Ekter/fishe/README.md

# fishe

This is the project of the Fishe.

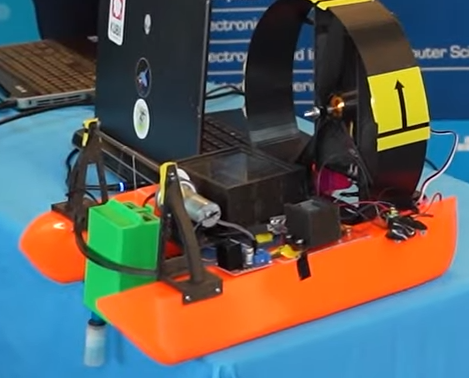
[picture p1: Reports/Reports_Nino_Mulac/images_and_videos_for_reports/fishe_photo_display.png]
Fishe


In fact, this is a high seas recon unit, whose purpose is to collect data on the environment.

Read the reports for further information.
