Ekter/fishe/Conception/README.md

# Conception

This folder will contain the 3D models of the pieces needed to build the robot alongside the 2D models of electronics circuits and laser beam cut pieces.

--------------------------------------------------------------------

Ce dossier contiendra les modèles 3D des pièces nécessaires à la construction du robot ainsi que les modèles 2D des circuits électroniques et des pièces découpées au laser.
