Ekter/fishe/Reports/Rapport_Nathan/Report20_ND.docx

Report 02/05/2023

During this last session before the presentation, I correct and print again pieces that had a problem during the printing. I also designed and print two box to protect the Jetson nano card and the Arduino nano that we use to order our robot.

After doing so I also work on the system of the pulley that and it was hand made.

I finished the session by filing the different piece that I have to make it more useful for the assembly.

We only have to assembly all of our piece together and test the floatability of the boat and also try all the program all together.
