Ekter/fishe/Reports/Rapport_Nathan/Report17_ND.docx

Report 21/03/2023

In this two hours session, I work on the piece that will link both of the pale of the rudder. It took some time to adapt it and make it at the exact length.

Moreover, due to my computer, the time need to work on Fusion360 increased. I need to switch between to project to have the exact length, and after that, I uploaded it on the complete protection project and assemble it to make verification and adapt it.

Finally I print it, to use it next time
