Ekter/fishe/Reports/Fishe diapo oral.pdf

# Fishe

Dumand Nathan
Mulac Nino
Rob3

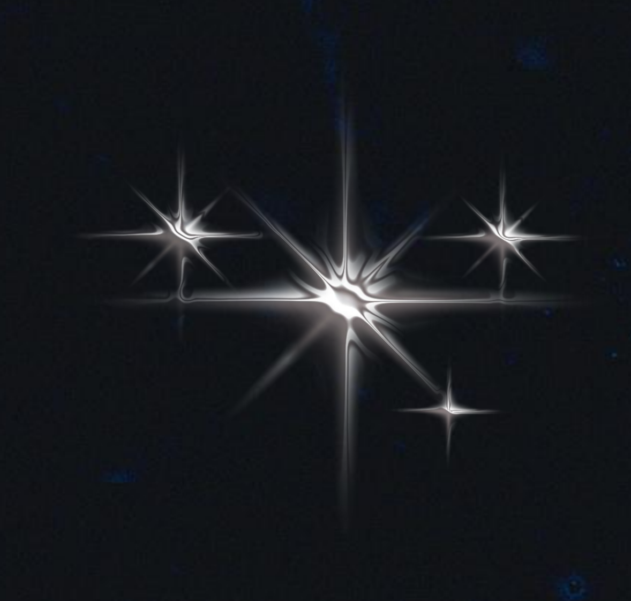
[picture p65: figure]

09/05/2023

Sommaire ● Fonctionnement général ● Le bateau ○ Mécanique ○ Électronique ○ Informatique ● La sonde ○ Mécanique ○ Électronique ○ Informatique

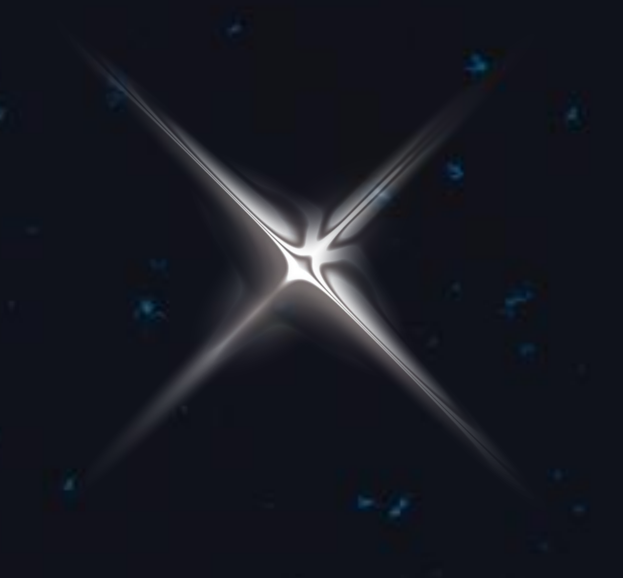
[picture p66: figure]

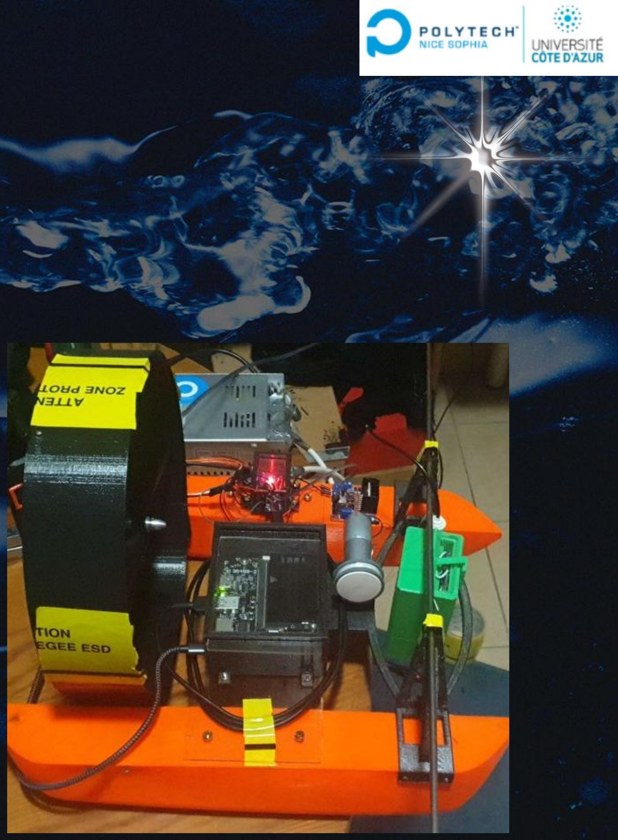
[picture p67: figure]

# Fonctionnement général

- Aéroglisseur
- Sonde
- Sauvegarde des données

# Le bateau

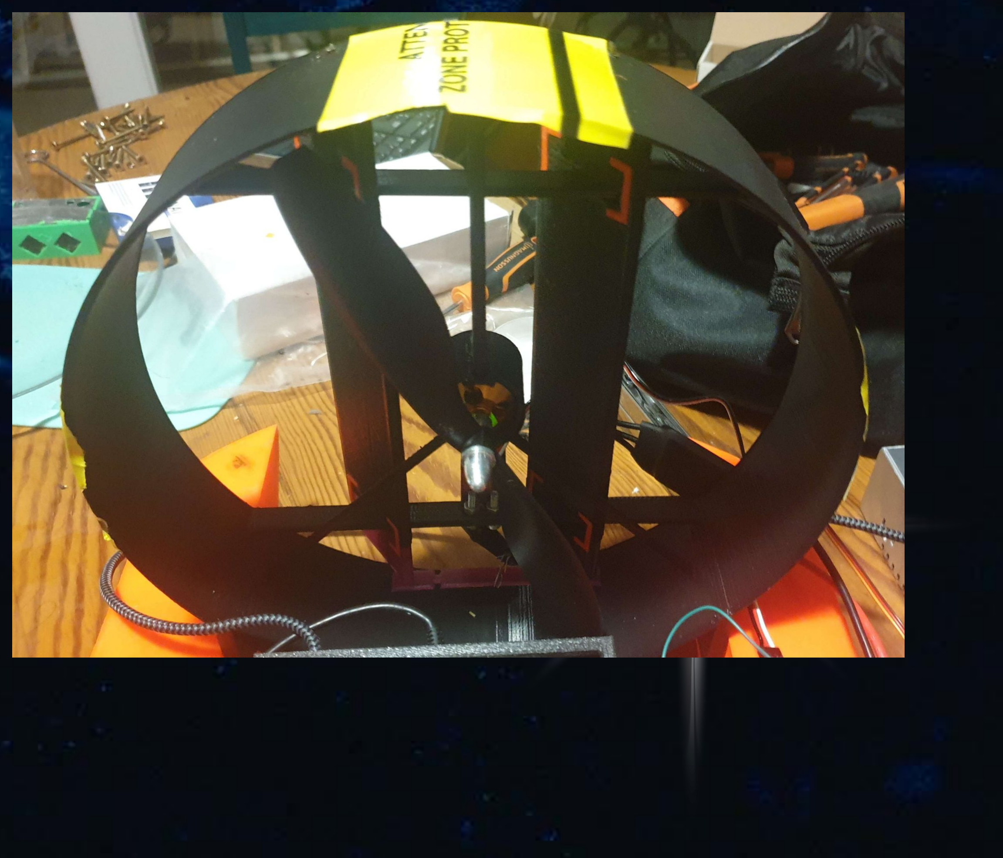
[picture p68: figure]

- Flotteur
- Système de déplacement
- Gouvernail
- Treuil

# Mécanique

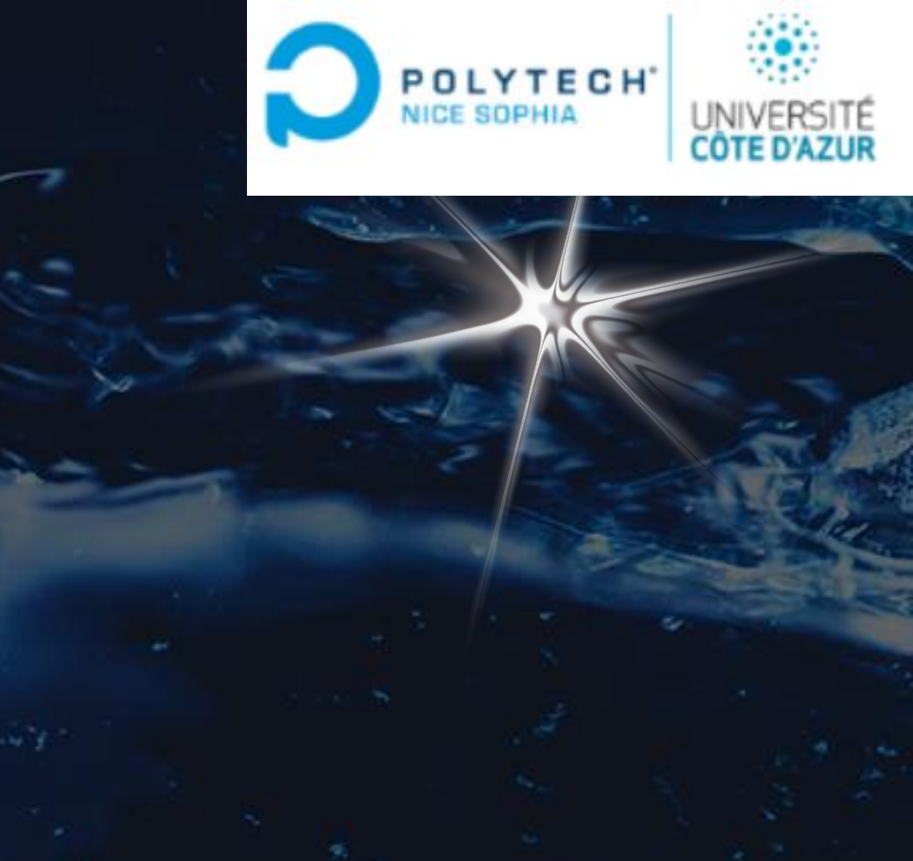
[picture p69: figure]

# Le bateau

# Électronique

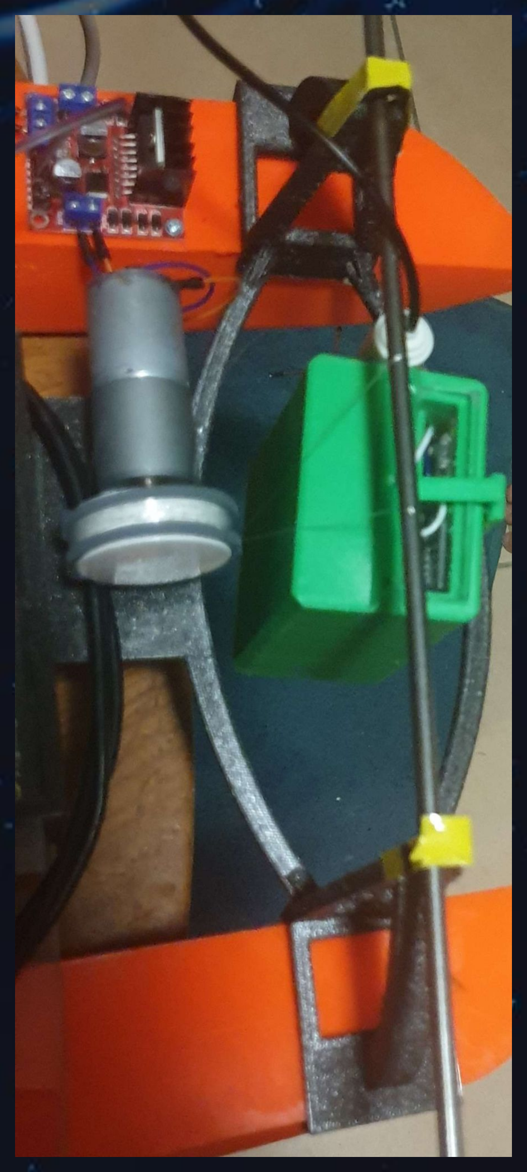
[picture p70: figure]
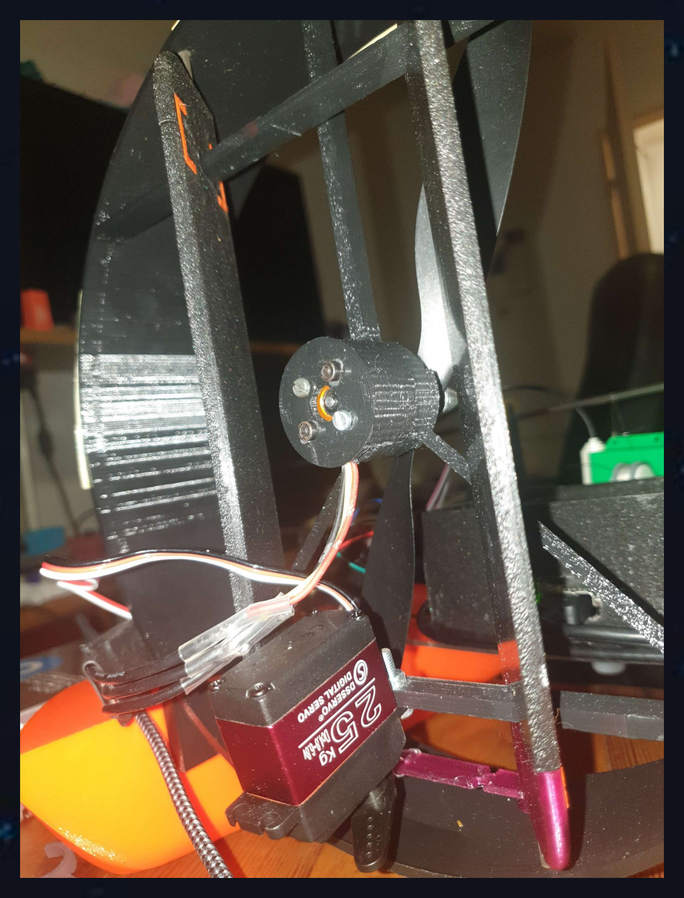
[picture p71: figure]

- Moteur
- Brushless + ESC
- Servo
- Moteur CC + pont en H
- 2 pistes de tension

# Le bateau

# Informatique

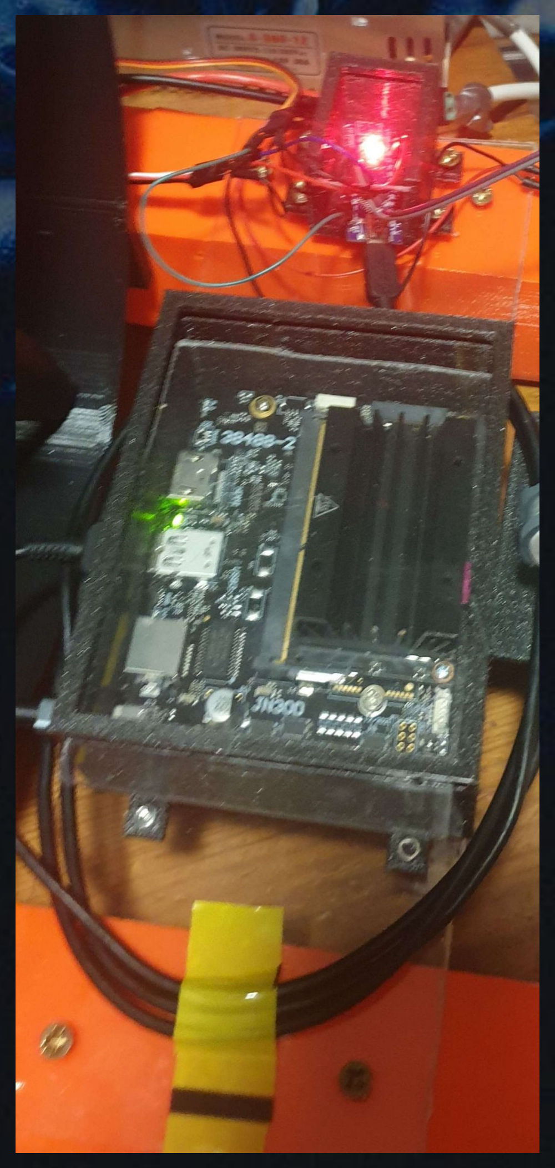
[picture p72: figure]

- Auvidea Jetson Nano
- Base de données
- Pilote du mouvement
- Arduino Nano
- Esclave
- Moteur

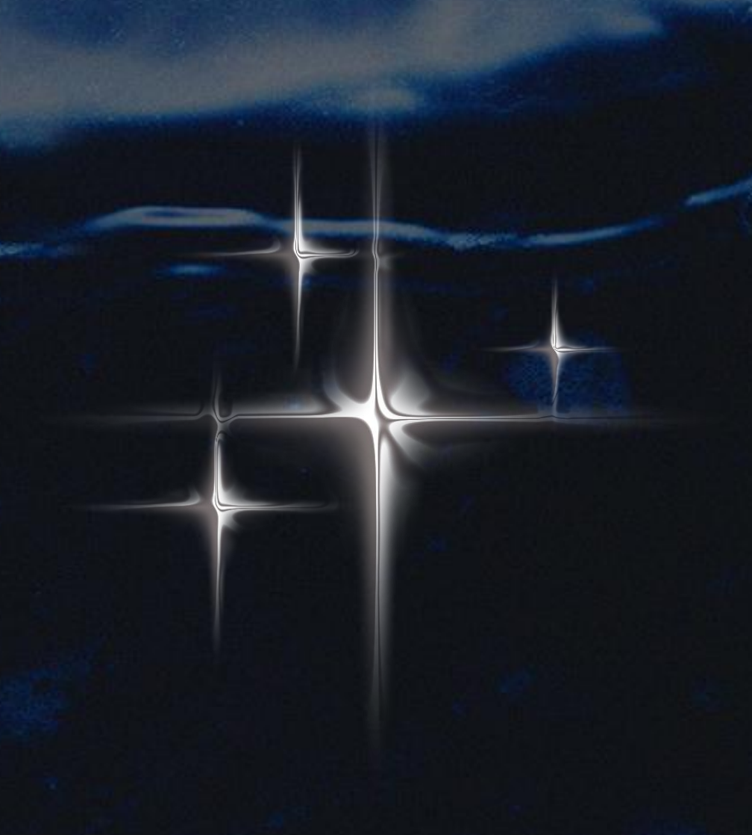
[picture p73: figure]

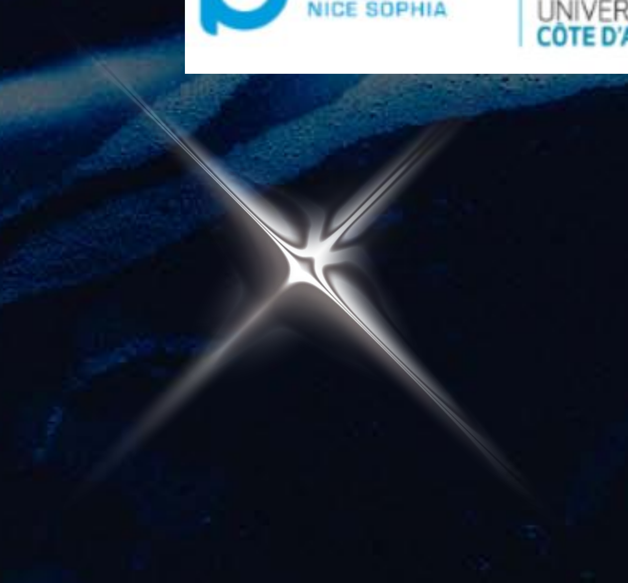
[picture p74: figure]

# La sonde

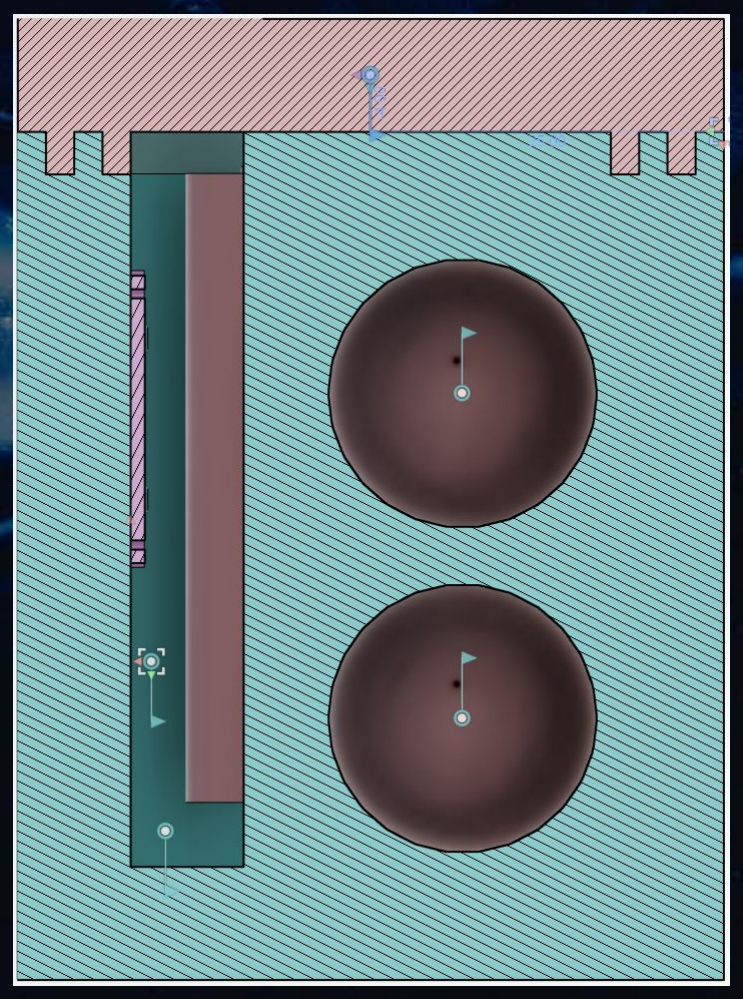
[picture p75: figure]

- Étanchéité
- Résistance aux fortes pressions

# Mécanique

# La sonde

# Électronique

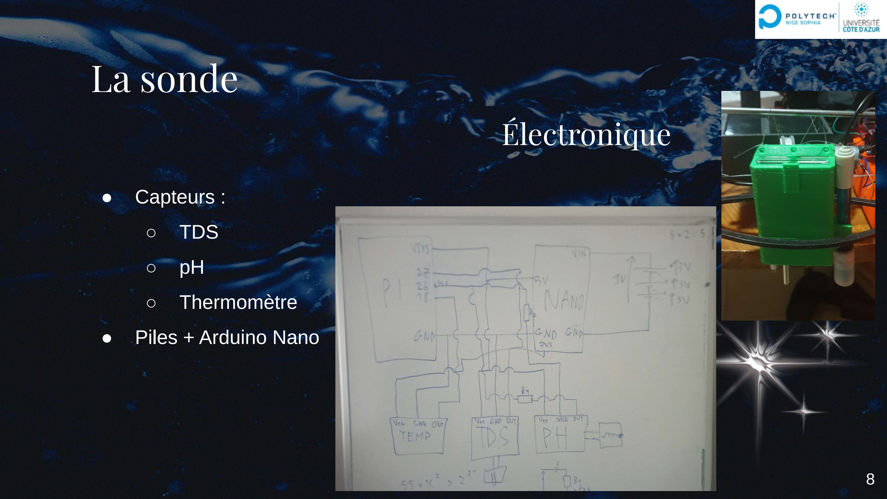
[picture p76: page 8]

- Capteurs :
- TDS
- pH
- Thermomètre
- Piles + Arduino Nano

# La sonde

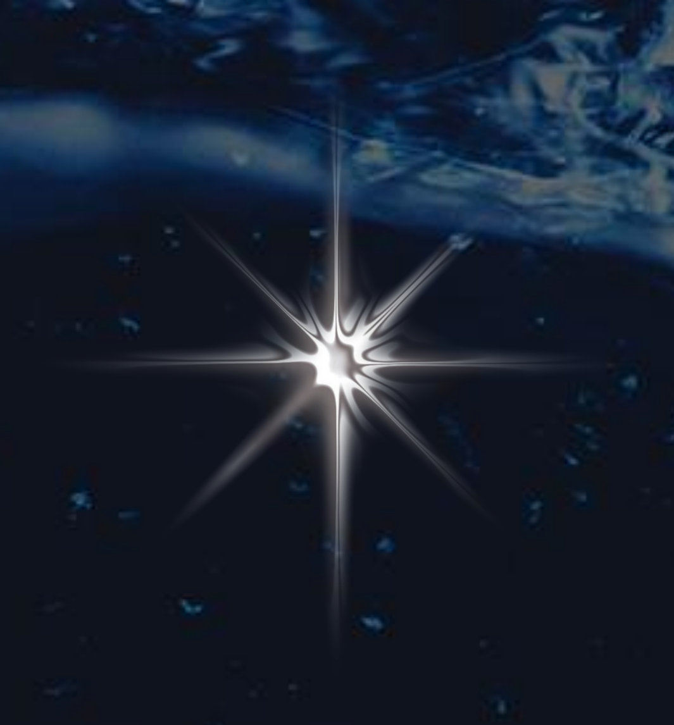
[picture p77: figure]

# Informatique

- Programme résistant au crash
- Lancement automatique
- Transmission d’information

# Démonstration

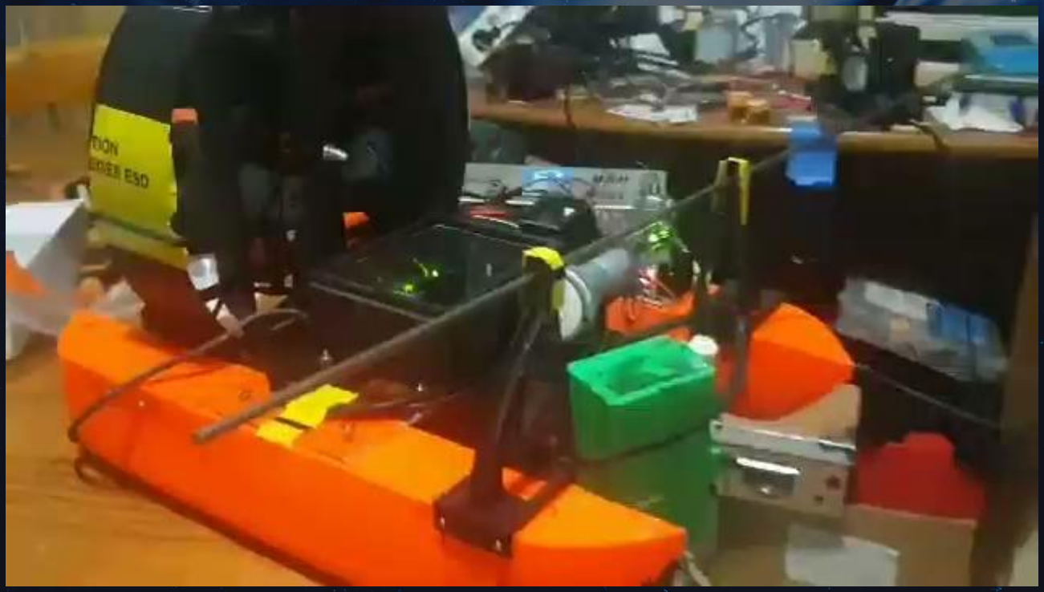
[picture p78: figure]

# Démonstration

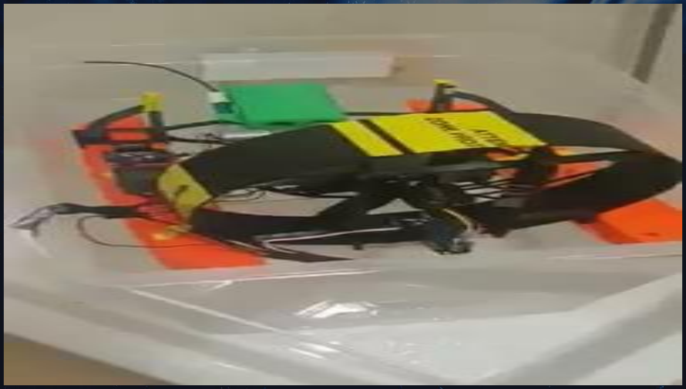
[picture p79: figure]

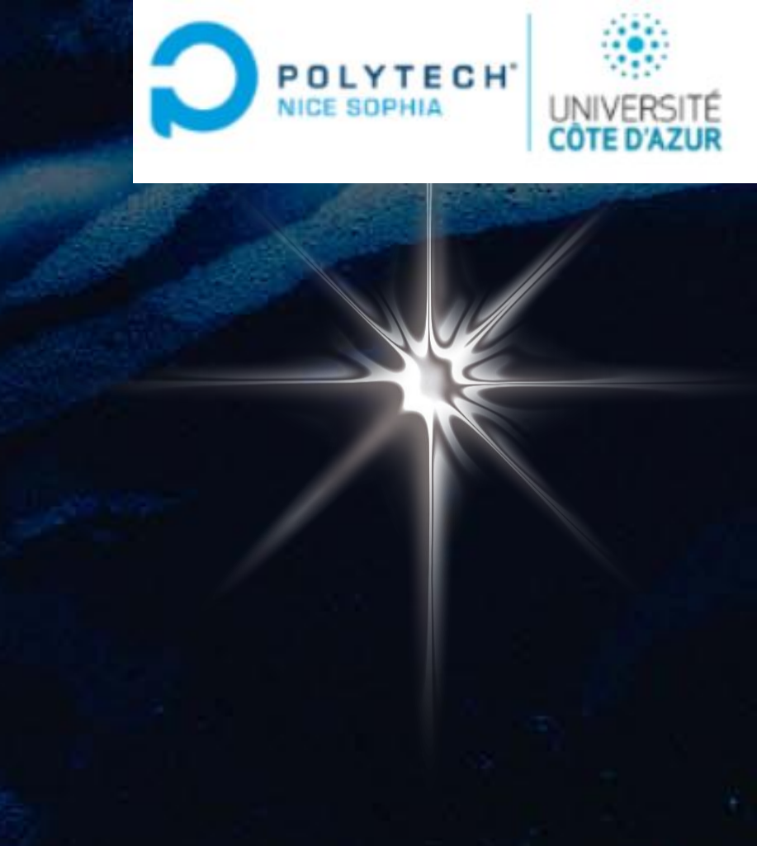
[picture p80: figure]

# Conclusion

- Batterie + panneaux solaires
- Résistance à l’eau
- Position GPS
- Profondeur de la sonde
- Repérage d’obstacle

### Bibliographie

How to reverse motor direction with ESC with reverse function? - Motors, Mechanics, Power and CNC - Arduino Forum
Reversing BLDC motor standard rotation.
Le robot inspiré des méduses se déplace comme le nageur le plus efficace de la nature jellyfish propulsion
How do jellyfish swim? | Earth | EarthSky
forces applied by swimming jellyfish
Drag coefficient - Wikipedia
profiles aerodynamics / hydrodynamics profiles NACA Intergovernmental Panel on Climate Change - Wikipedia AR6 Synthesis Report: Climate Change 2022 — IPCC Carbon dioxide - Wikipedia
Arduino based hovercraft
aircraft propellers and how they work
