Ekter/fishe/Reports/README.md

# Code

This folder will contain all reports. This includes the initial report, the weekly reports, the final report, and the presentation slides.

--------------------------------------------------------------------

Ce dossier contiendra tous les rapports. Cela inclut le rapport initial, les rapports hebdomadaires, le rapport final, et les diapositives de la présentation.
