Ekter/fishe/Models/README.md

# Conception

This folder will contain the physical modelisations for the robot.

--------------------------------------------------------------------

Ce dossier contiendra les modélisations physiques du robot.
