Ekter/fishe/Archives/README.md

# Code

This folder contains old versions of the code, and other things not needed anymore. The current version is in the [Code](../Code) folder.

--------------------------------------------------------------------

Ce dossier contient les anciennes versions du code, et d'autres choses qui ne sont plus nécessaires. La version actuelle est dans le dossier [Code](../Code).
