Ekter/fishe/Reports/Reports_Nino_Mulac/images_and_videos_for_reports/electrical_diagram_boat_nice.png

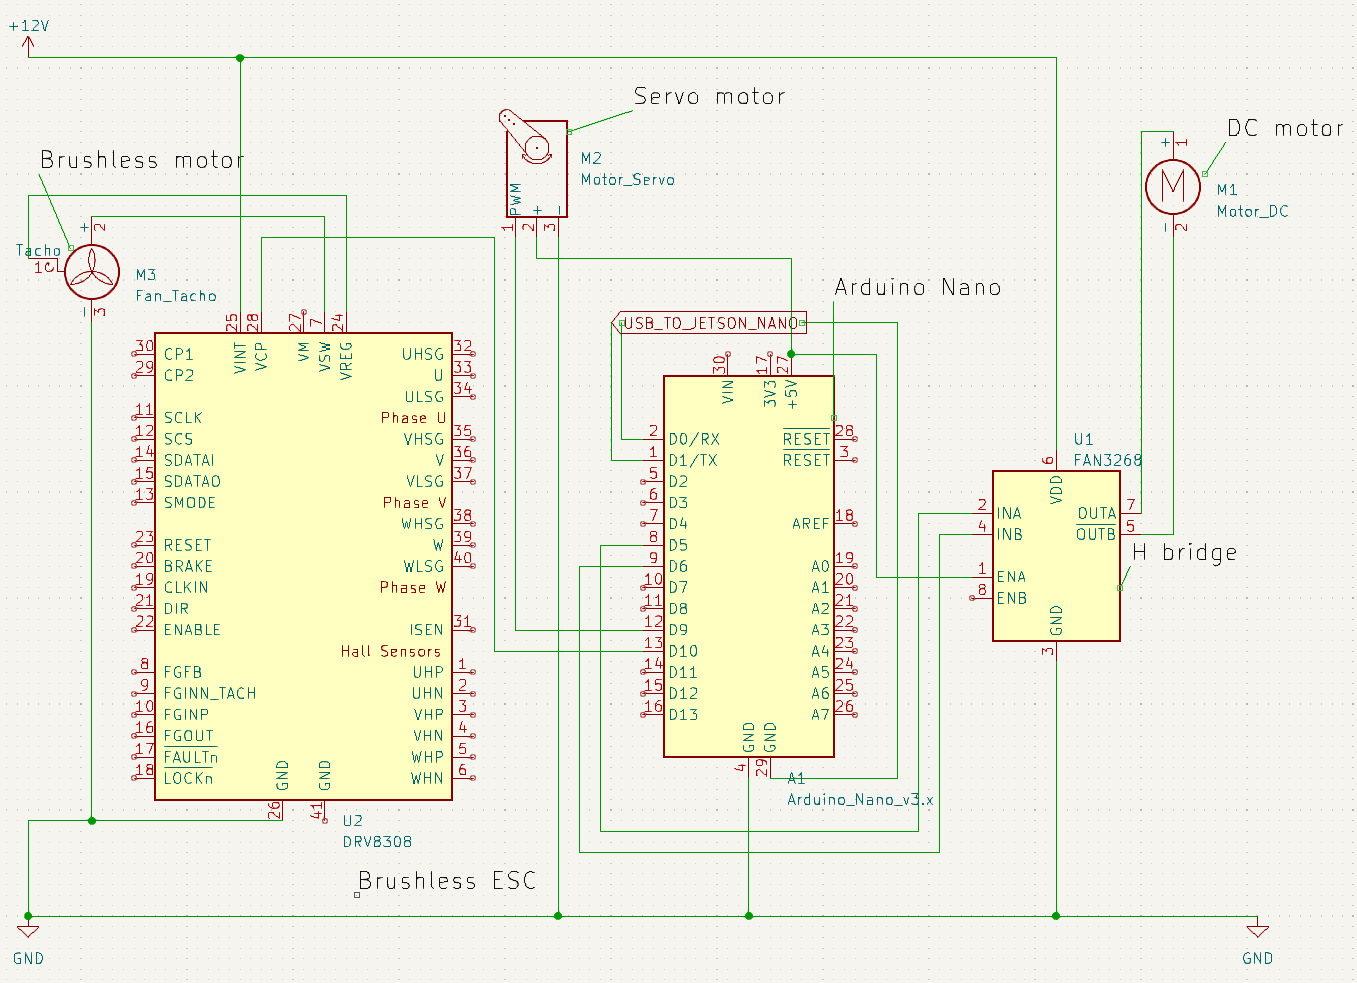
Reports/Reports_Nino_Mulac/images_and_videos_for_reports/electrical_diagram_boat_nice.png
