Ekter/fishe/Reports/Reports_Nino_Mulac/images_and_videos_for_reports/fishe_photo_display_2.png

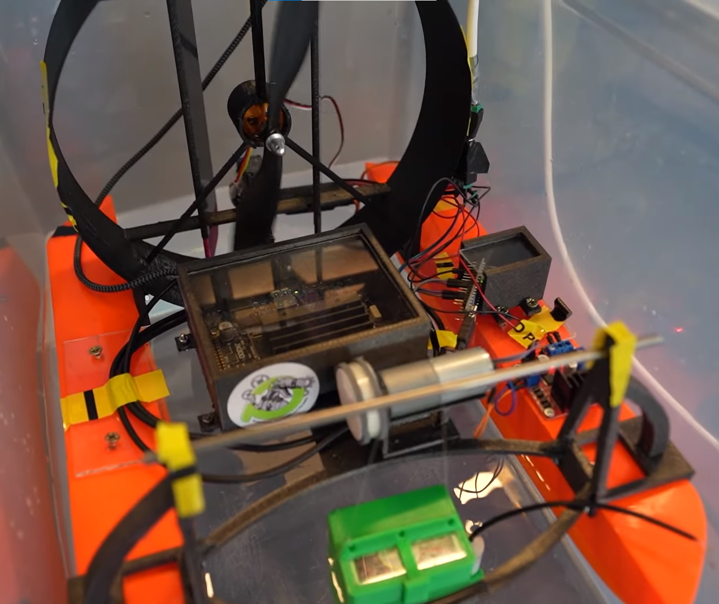
Reports/Reports_Nino_Mulac/images_and_videos_for_reports/fishe_photo_display_2.png
