Ekter/fishe/Reports/Reports_Nino_Mulac/images_and_videos_for_reports/temp_fishe/new/IMG_20230207_115417_1CS.jpg

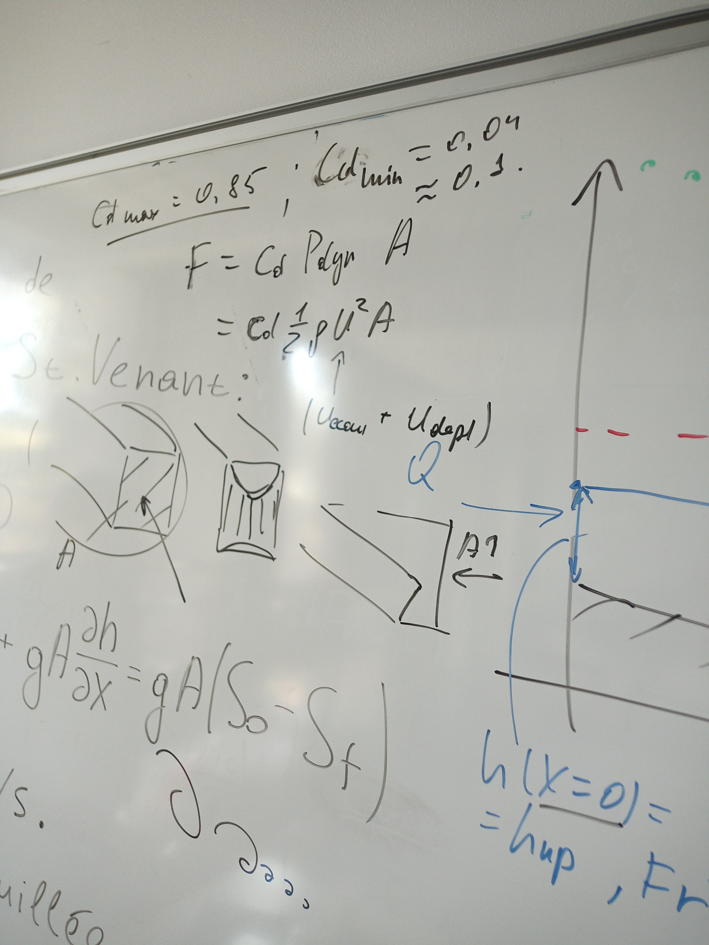
Reports/Reports_Nino_Mulac/images_and_videos_for_reports/temp_fishe/new/IMG_20230207_115417_1CS.jpg
