Ekter/fishe/Reports/materials_needed.md

#
Materials Needed
----------------

Here is the list of all things necessary to build the project.

* Fisher wire
* Turbidity sensor
* Small battery for the recon unit
* Batterie Lipo 3s 6500mAh 80C 11.1V 
* ESC 30A Lynxmotion Multirotor BEC 1A (Avec Connecteurs) - RobotShop
* Kyrio A2212 Brushless Motor 2200KV Outrunner Brushless Motor
* Waterproof servomotor
* induction Qi coil
* AZDelivery ESP8266X ESP-01S WLAN Module WiFi Compatible avec Arduino et Raspberry Pi

^voir rapport
* [Solutions étalon pour sonde pH](https://www.planete-domotique.com/kit-solution-d-etalonnage-pour-sonde-ph-solution-tampon-wizelec.html)
* [mtoreductor](https://www.amazon.fr/R%C3%A9ducteur-%C3%A9lectrique-engrenages-velocidad-el%C3%A9ctrico/dp/B09J2QH8MW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)
