Ekter/fishe/Conception/3D_models/link rudder v1.3mf

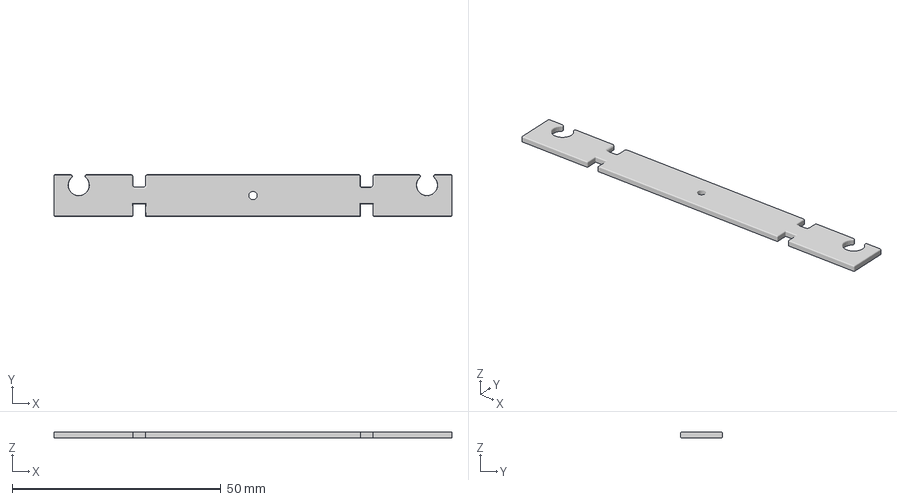
[picture p85: CAD file, 2023-03-21]
Conception/3D_models/link rudder v1.3mf
95.4 x 10.0 x 1.50 mm
