Ekter/fishe/Conception/support sonde v3.3mf

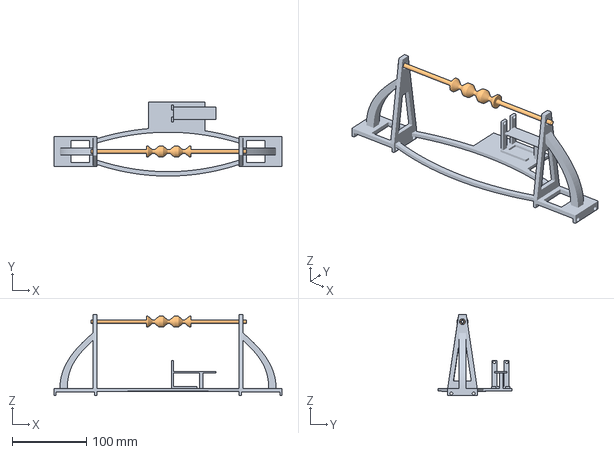
[picture p86: CAD file, 2023-05-09]
Conception/support sonde v3.3mf
308.0 x 100.2 x 110.0 mm
Corps10
Corps5
