Ekter/fishe/Conception/3D_models/fishell3mf.3mf

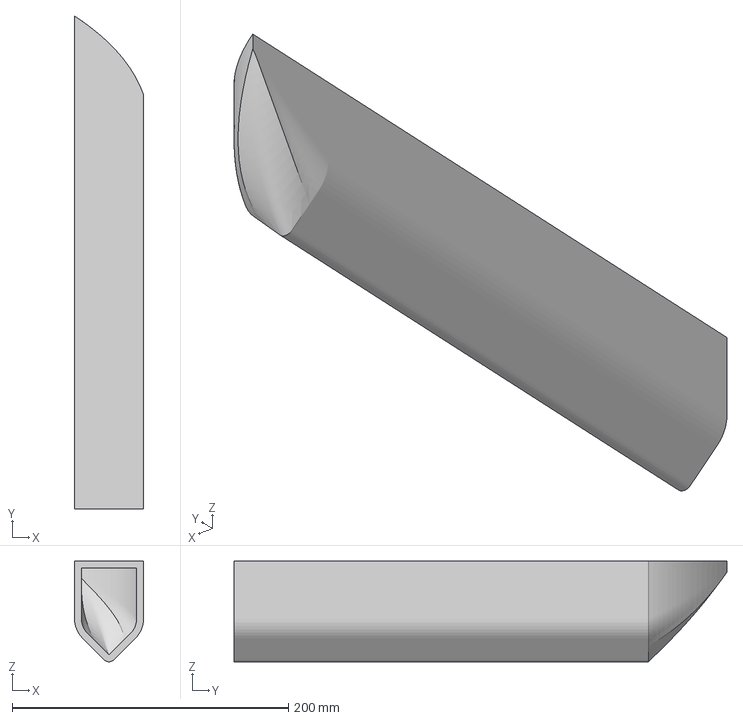
[picture p87: CAD file, 2022-12-17]
Conception/3D_models/fishell3mf.3mf
50.1 x 357.0 x 72.9 mm
