Ekter/fishe/Conception/3D_models/fishell.3mf

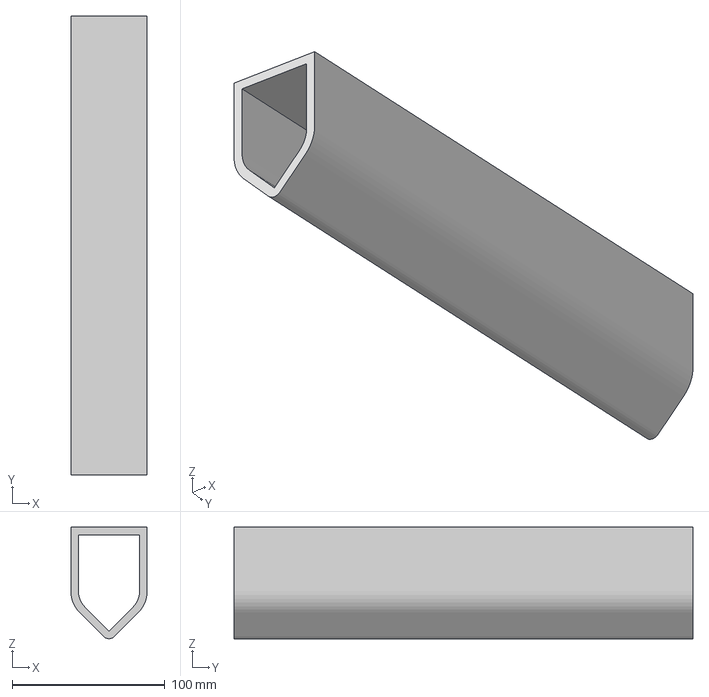
[picture p88: CAD file, 2022-12-17]
Conception/3D_models/fishell.3mf
50.0 x 300.0 x 72.9 mm
