Ekter/fishe/Conception/3D_models/nazefishe.3mf

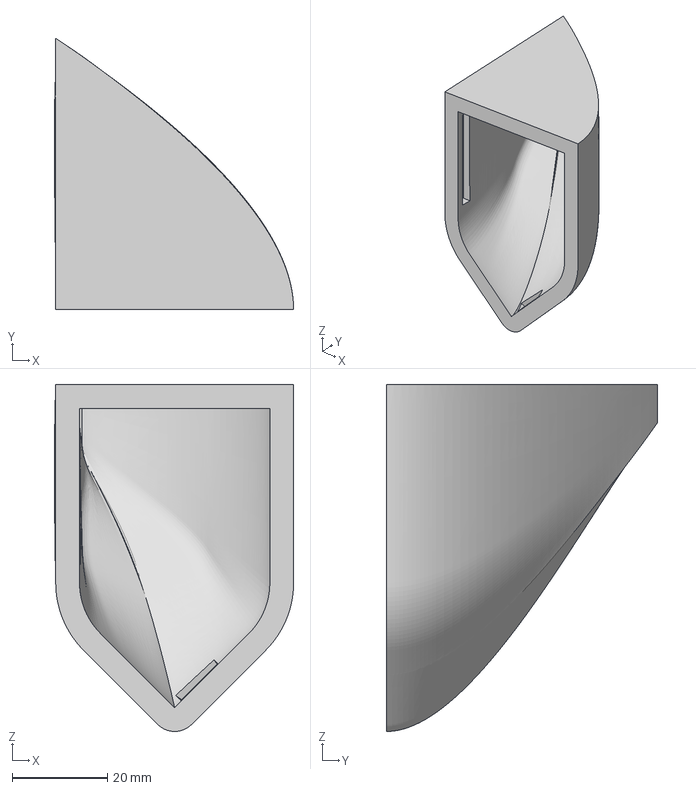
[picture p89: CAD file, 2022-12-17]
Conception/3D_models/nazefishe.3mf
50.3 x 57.0 x 72.9 mm
