Ekter/fishe/Conception/3D_models/thrust cover center v2.3mf

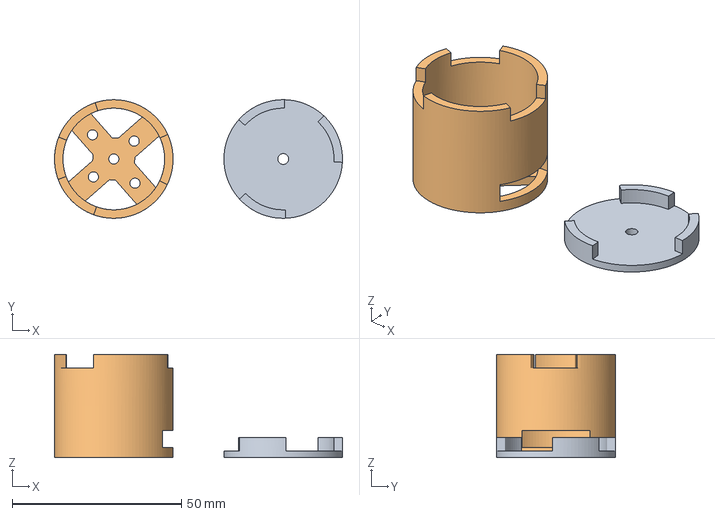
[picture p90: CAD file, 2022-12-17]
Conception/3D_models/thrust cover center v2.3mf
85.0 x 35.0 x 30.5 mm
Corps1
Corps2
