Ekter/fishe/Conception/3D_models/rear rudder v5.3mf

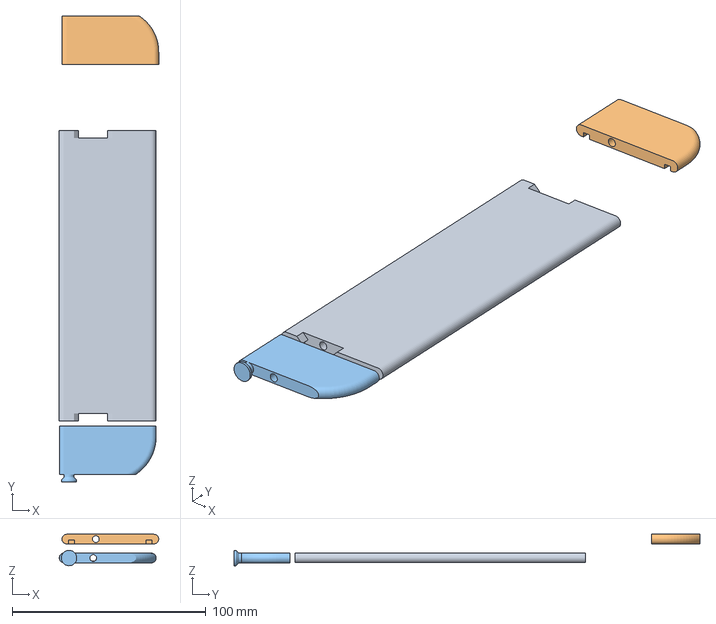
[picture p91: CAD file, 2022-12-17]
Conception/3D_models/rear rudder v5.3mf
51.4 x 240.6 x 16.3 mm
Corps1 x 3
