Ekter/fishe/Conception/3D_models/U v1.3mf

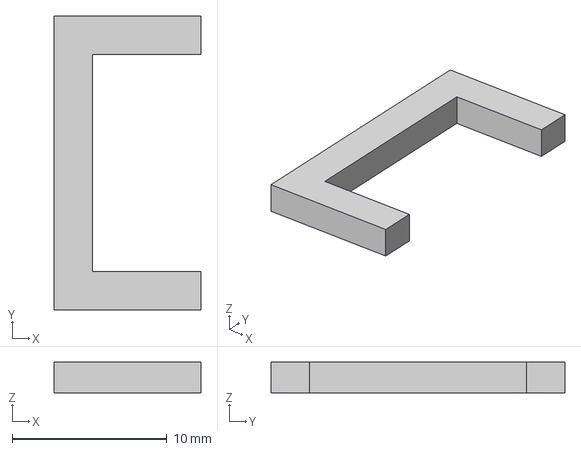
[picture p92: CAD file, 2022-12-09]
Conception/3D_models/U v1.3mf
9.50 x 19.0 x 2.00 mm
