Ekter/fishe/Conception/3D_models/thrust_cover.3mf

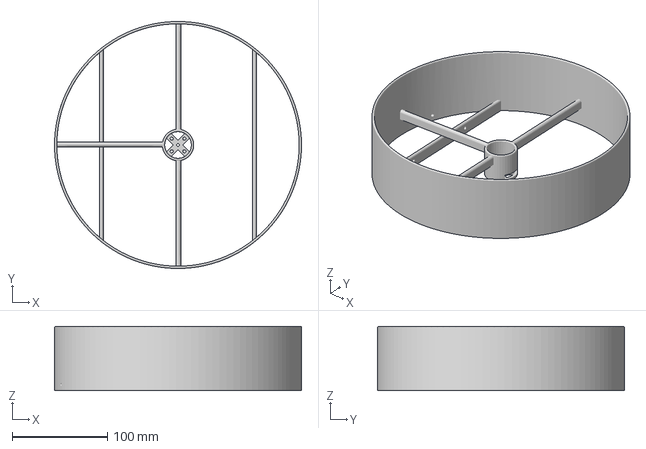
[picture p93: CAD file, 2022-11-25]
Conception/3D_models/thrust_cover.3mf
259.0 x 259.0 x 67.5 mm
