Ekter/fishe/Conception/3D_models/thrust cover center v1.3mf

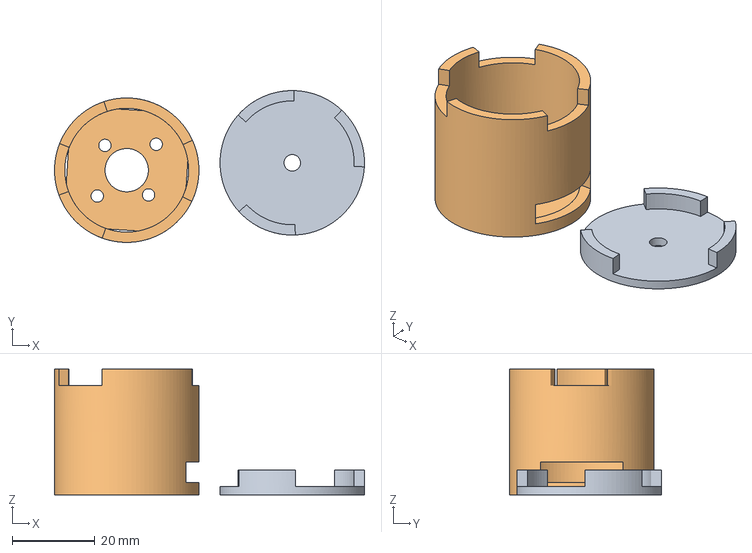
[picture p94: CAD file, 2023-03-07, an earlier design]
Conception/3D_models/thrust cover center v1.3mf
75.1 x 36.8 x 30.5 mm
Corps1
Corps2
