Ekter/fishe/(list of files, cad)

Other CAD files:
Conception/support sonde v3.f3d
annex_work/Arduino_Case/Case_Nathan/socle arduino Nathan_Dumand.f3d
annex_work/Arduino_Case/Case_Nino/boite raspy pico Nino Mulac.f3z
