Ekter/fishe/Codes/Test/brushless_rotationspeed/evo moteur.png

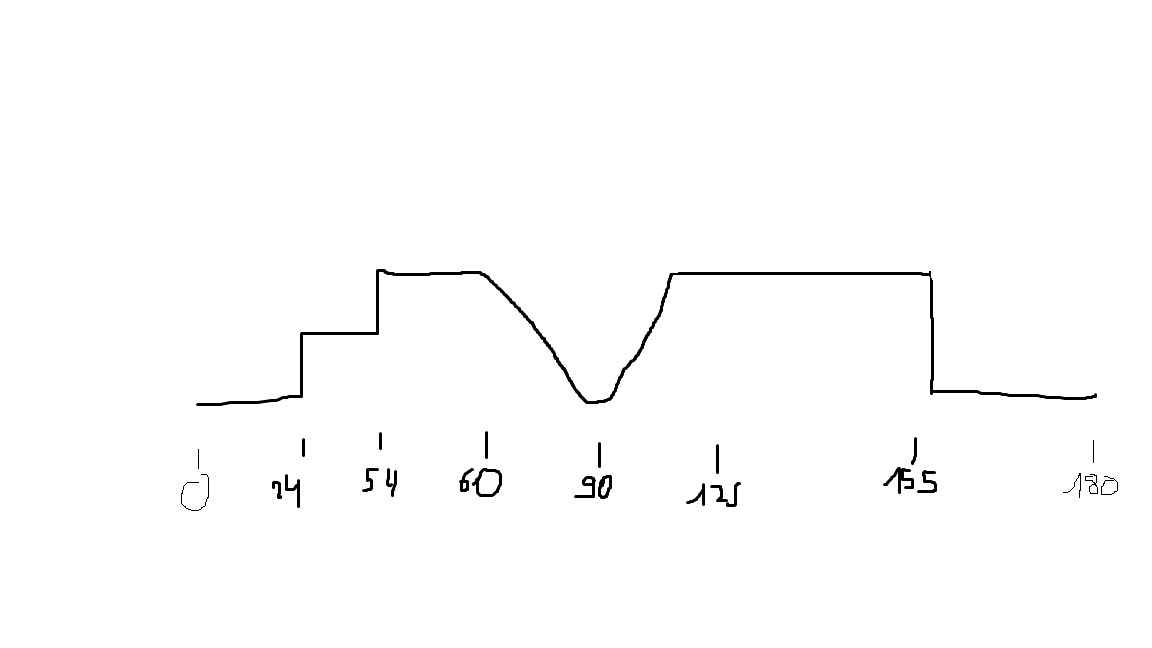
Codes/Test/brushless_rotationspeed/evo moteur.png
