Ekter/fishe/Reports/Gantt Chart.pdf

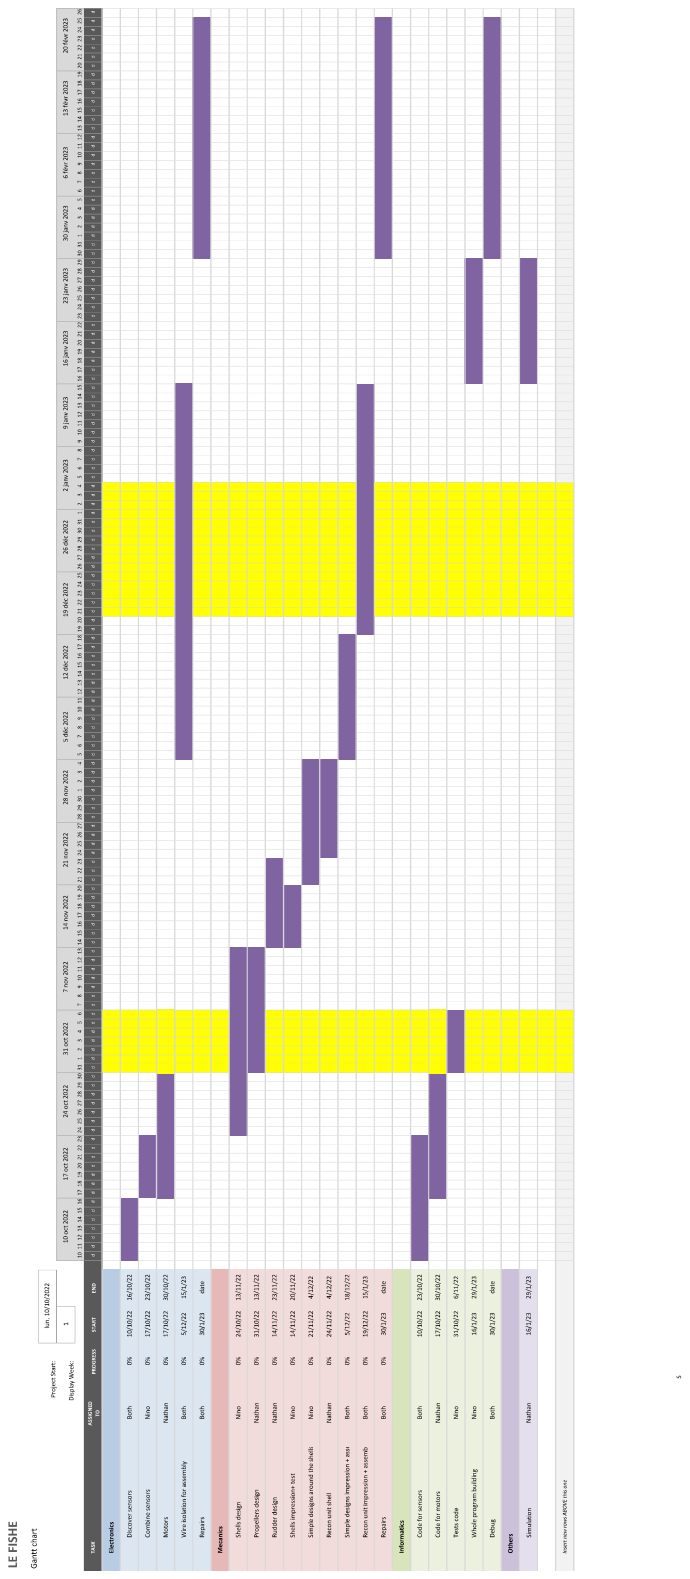
[picture p105: page 1]
