Ekter/fishe/Conception/electrical_design_fishe_kicad/electrical_design_fishe_kicad.kicad_pcb

## KiCad design Effector81_SynthDrum/Effector81_SynthDrum/PowerSupply.kicad_sch

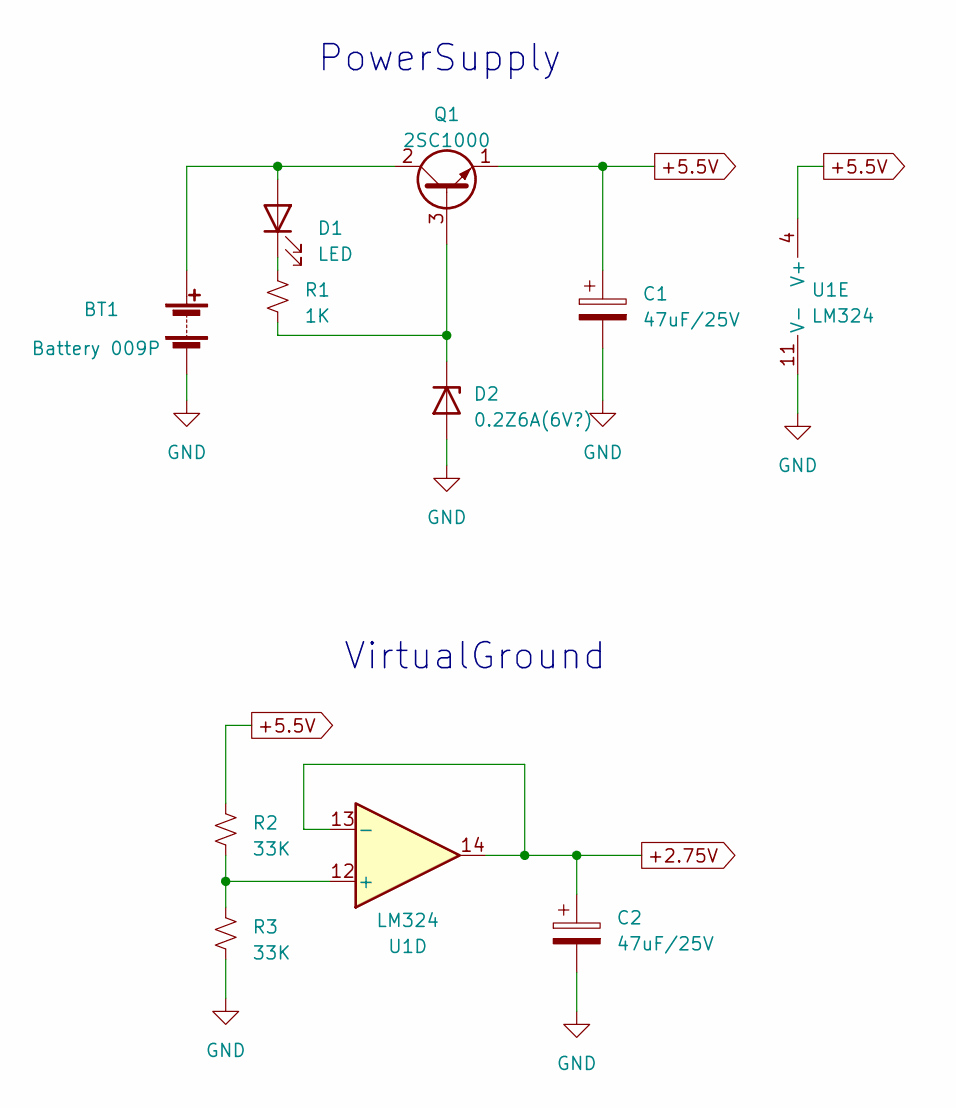
[picture p106: schematic PowerSupply.kicad_sch]

Parts:
BT1: Battery 009P; BatteryHolder_MPD_BA9VPC_1xPP3
C1, C2: 47uF/25V; CP_Radial_D5.0mm_P2.00mm
D1: LED; LED_D5.0mm
D2: 0.2Z6A(6V?); D_DO-34_SOD68_P7.62mm_Horizontal
Q1: 2SC1000; TO-92_Inline
R1: 1K; R_Axial_DIN0207_L6.3mm_D2.5mm_P10.16mm_Horizontal
R2, R3: 33K; R_Axial_DIN0207_L6.3mm_D2.5mm_P10.16mm_Horizontal
U1: LM324; DIP-14_W7.62mm_LongPads

Connections:
+2.75V: C2.1, U1.13 (-), U1.14
+5.5V: C1.1, Q1.1 (E), R2.1, U1.4 (V+)
GND: BT1.2 (-), C1.2, C2.2, D2.2 (A), R3.2, U1.11 (V-)
unnamed: BT1.1 (+), D1.2 (A), Q1.2 (C)
unnamed: D1.1 (K), R1.1
unnamed: D2.1 (K), Q1.3 (B), R1.2
unnamed: R2.2, R3.1, U1.12 (+)

Notes on the sheet:
VirtualGround
PowerSupply
