Ekter/fishe/Conception/electrical_design_fishe_kicad/electrical_design_fishe_kicad.kicad_pcb

## KiCad design Effector81_SynthDrum/Effector81_SynthDrum/Synth.kicad_sch

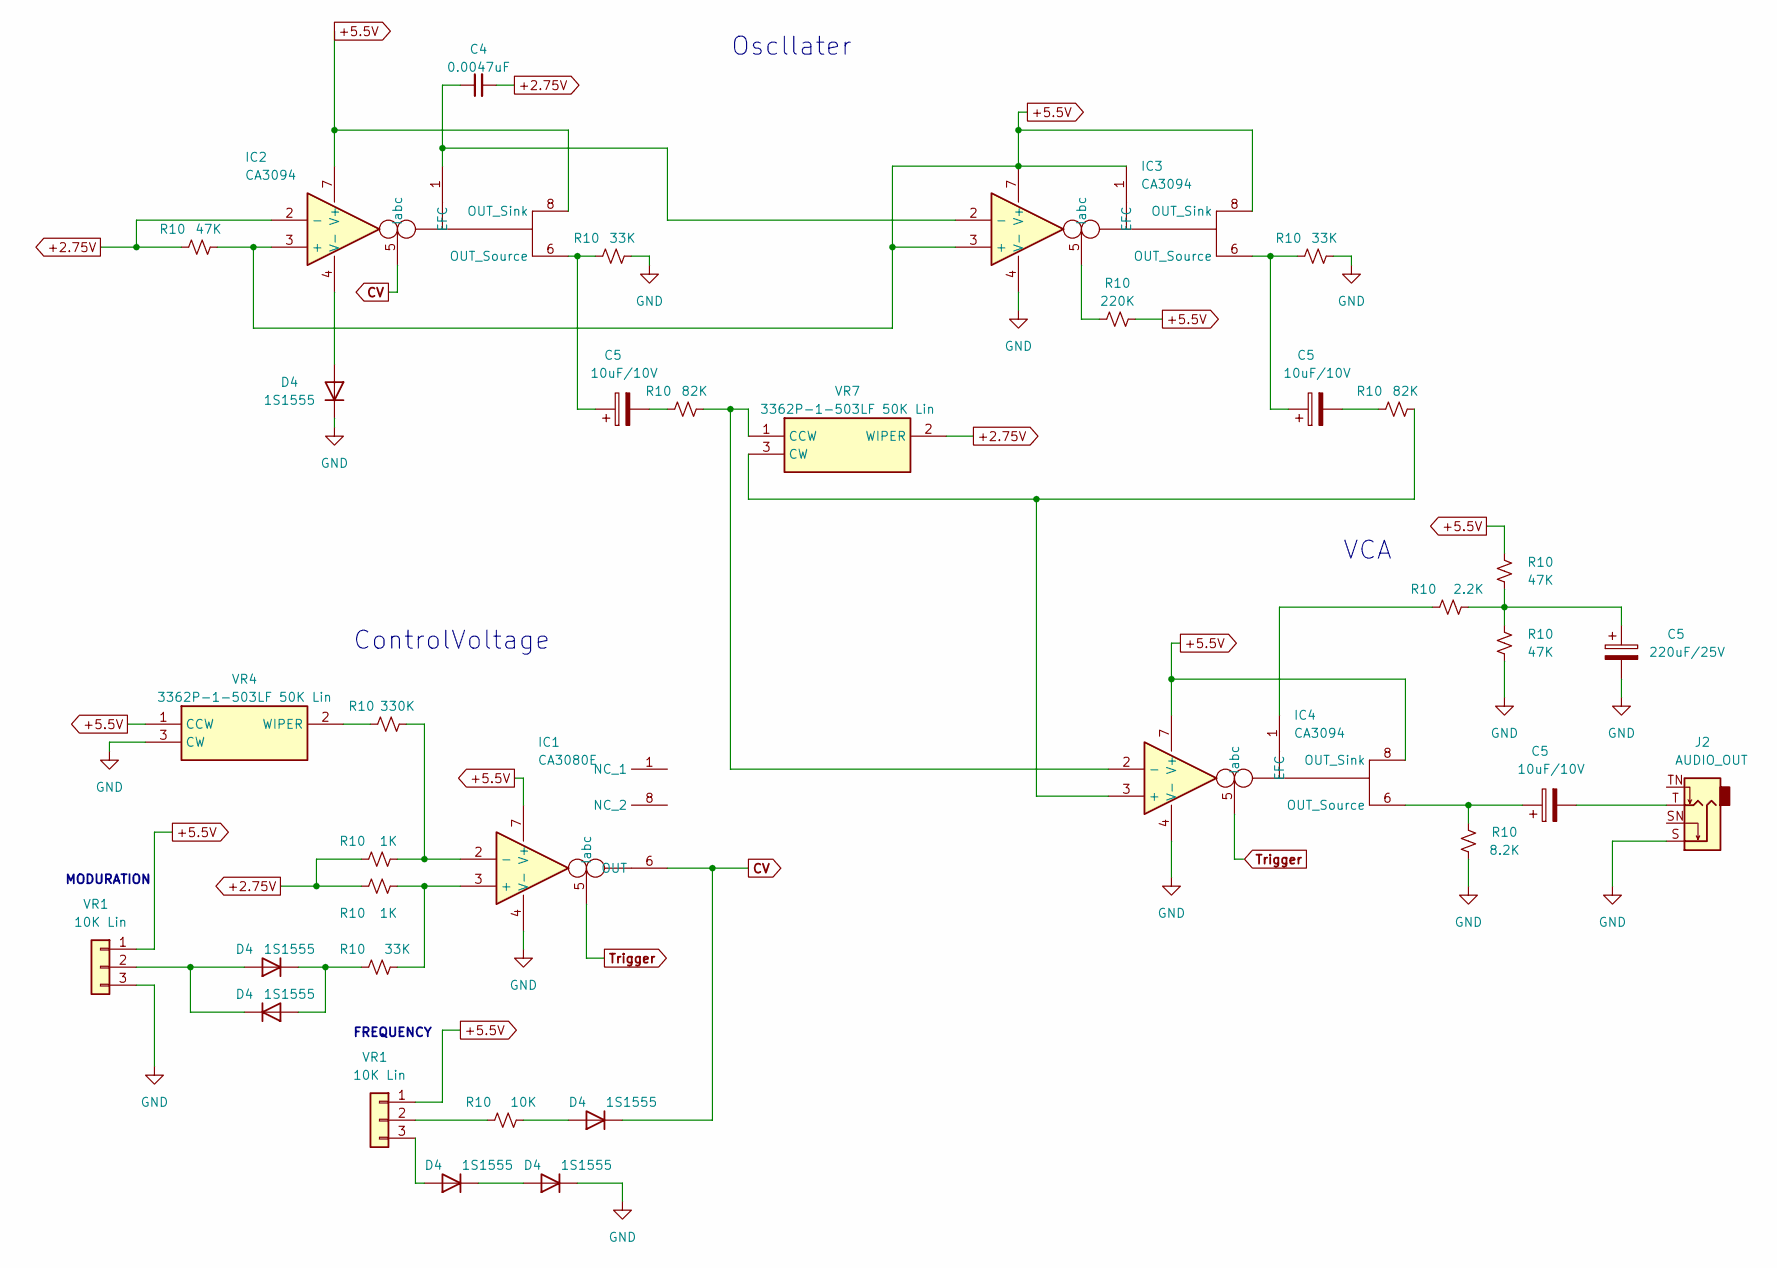
[picture p107: schematic Synth.kicad_sch]

Parts:
C4: 0.0047uF; C_Axial_L3.8mm_D2.6mm_P7.50mm_Horizontal
C5: 10uF/10V; CP_Radial_D5.0mm_P2.00mm
D4: 1S1555; D_DO-35_SOD27_P7.62mm_Horizontal
IC1: CA3080E; DIP794W56P254L958H533Q8N; Manufacturer_Part_Number CA3080E; Mouser Part Number N/A
IC2, IC3, IC4: CA3094; DIP794W56P254L958H533Q8N; Manufacturer_Part_Number CA3080E; Mouser Part Number N/A
J2: AUDIO_OUT; Jack_6.35mm_Neutrik_NMJ4HFD2_Horizontal
R10: 33K; R_Axial_DIN0207_L6.3mm_D2.5mm_P10.16mm_Horizontal
VR1: 10K Lin; PinHeader_1x03_P2.54mm_Vertical
VR4, VR7: 3362P-1-503LF 50K Lin; 3362P_1; Manufacturer_Part_Number 3362P-1-103LF; Mouser Part Number 652-3362P-1-103LF

Connections:
+2.75V: C4.2, IC2.2 (-), R10.2, VR7.2 (WIPER)
+5.5V: IC1.7 (V+), IC2.3 (+), IC2.7 (V+), IC2.8 (OUT_Sink), IC3.1 (EFC), IC3.3 (+), IC3.7 (V+), IC3.8 (OUT_Sink), IC4.7 (V+), IC4.8 (OUT_Sink), R10.1, VR1.1, VR4.1 (CCW)
CV: D4.1 (K), IC1.6 (OUT), IC2.5 (Iabc)
GND: C5.2, D4.1 (K), IC1.4 (V-), IC3.4 (V-), IC4.4 (V-), J2.S, R10.1, R10.2, VR1.3, VR4.3 (CW)
unnamed: C4.1, IC2.1 (EFC), IC3.2 (-)
unnamed: C5.1, IC2.6 (OUT_Source), IC3.6 (OUT_Source), IC4.6 (OUT_Source), R10.1, R10.2
unnamed: C5.2, J2.T, R10.2
unnamed: D4.1 (K), D4.2 (A), R10.2, VR1.2
unnamed: D4.2 (A), IC2.4 (V-), R10.1, VR1.3
unnamed: IC1.2 (-), R10.1
unnamed: IC1.3 (+), R10.1
unnamed: IC3.5 (Iabc), R10.2
unnamed: IC4.1 (EFC), R10.1
unnamed: IC4.2 (-), R10.1, VR7.1 (CCW)
unnamed: IC4.3 (+), R10.1, VR7.3 (CW)
unnamed: R10.2, VR1.2, VR4.2 (WIPER)
Trigger: IC1.5 (Iabc)

Notes on the sheet:
VCA
Oscllater
MODURATION
FREQUENCY
ControlVoltage
