Ekter/fishe/Conception/electrical_design_fishe_kicad/electrical_design_fishe_kicad.kicad_pcb

## KiCad design Effector81_SynthDrum/Effector81_SynthDrum/Trigger.kicad_sch

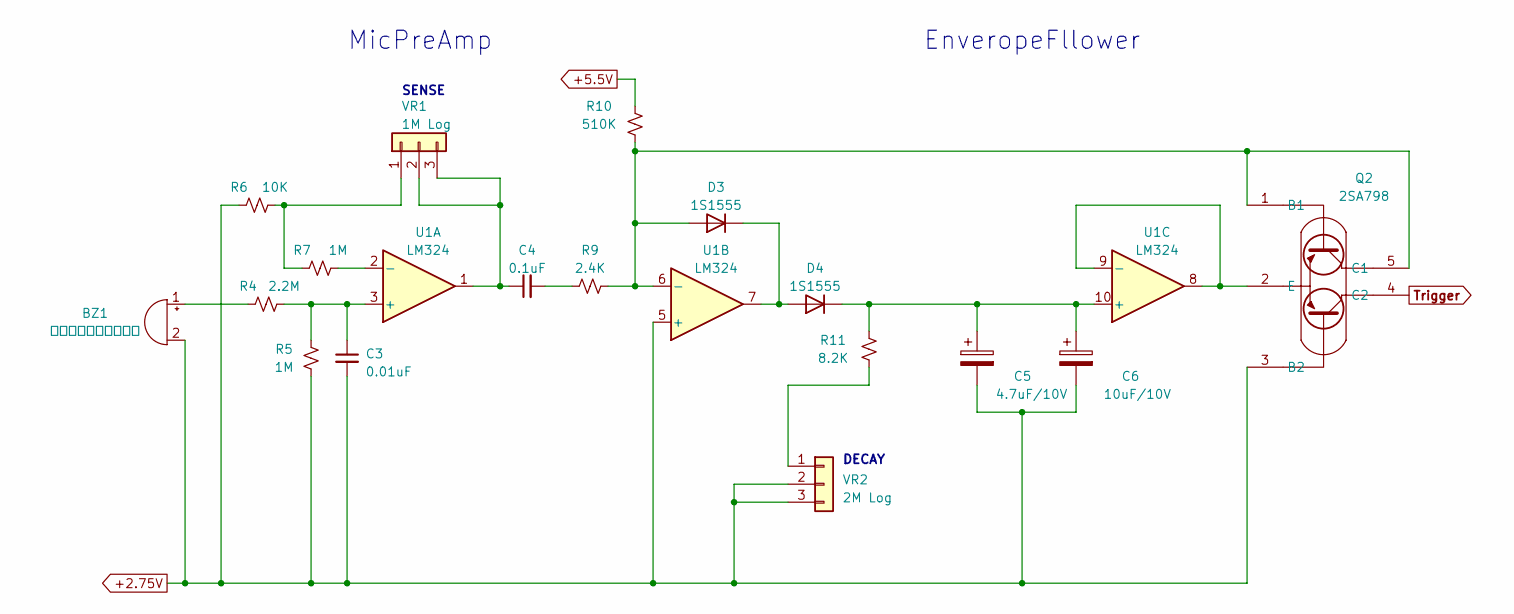
[picture p108: schematic Trigger.kicad_sch]

Parts:
BZ1: セラミックスピーカー; PinHeader_1x02_P2.54mm_Vertical
C3: 0.01uF; C_Axial_L3.8mm_D2.6mm_P7.50mm_Horizontal
C4: 0.1uF; C_Axial_L3.8mm_D2.6mm_P7.50mm_Horizontal
C5: 4.7uF/10V; CP_Radial_D5.0mm_P2.00mm
C6: 10uF/10V; CP_Radial_D5.0mm_P2.00mm
D3, D4: 1S1555; D_DO-35_SOD27_P7.62mm_Horizontal
Q2: 2SA798; HN4A06JTE85LF; Manufacturer_Part_Number HN4A06J(TE85L,F); Mouser Part Number 757-HN4A06JTE85LF
R4: 2.2M; R_Axial_DIN0207_L6.3mm_D2.5mm_P10.16mm_Horizontal
R5, R7: 1M; R_Axial_DIN0207_L6.3mm_D2.5mm_P10.16mm_Horizontal
R6: 10K; R_Axial_DIN0207_L6.3mm_D2.5mm_P10.16mm_Horizontal
R9: 2.4K; R_Axial_DIN0207_L6.3mm_D2.5mm_P10.16mm_Horizontal
R10: 510K; R_Axial_DIN0207_L6.3mm_D2.5mm_P10.16mm_Horizontal
R11: 8.2K; R_Axial_DIN0207_L6.3mm_D2.5mm_P10.16mm_Horizontal
U1: LM324; DIP-14_W7.62mm_LongPads
VR1: 1M Log; PinHeader_1x03_P2.54mm_Vertical
VR2: 2M Log; PinHeader_1x03_P2.54mm_Vertical

Connections:
+2.75V: BZ1.2 (+), C3.2, C5.2, C6.2, Q2.3 (B2), R5.1, R6.1, U1.5 (+), VR2.2, VR2.3
+5.5V: R10.2
unnamed: BZ1.1 (-), R4.1
unnamed: C3.1, R4.2, R5.2, U1.3 (+)
unnamed: C4.1, U1.1, VR1.2, VR1.3
unnamed: C4.2, R9.1
unnamed: C5.1, C6.1, D4.1 (K), R11.2, U1.10 (+)
unnamed: D3.1 (K), D4.2 (A), U1.7
unnamed: D3.2 (A), Q2.1 (B1), Q2.5 (C1), R9.2, R10.1, U1.6 (-)
unnamed: Q2.2 (E), U1.8, U1.9 (-)
unnamed: R6.2, R7.1, VR1.1
unnamed: R7.2, U1.2 (-)
unnamed: R11.1, VR2.1
Trigger: Q2.4 (C2)

Notes on the sheet:
DECAY
EnveropeFllower
SENSE
MicPreAmp
