Ekter/fishe/annex_work/Morse/Morse_Nino/Translator.h

#include "Morse.h"

class Translator
{
private:
    Morse mor;
    void action(char*);
public:
    Translator(int pin);
    Translator();
    ~Translator();
    void translate(char);
    void translateword(char*);
    void makeaction();
};
