Ekter/fishe/Codes/Test/cours2/.other/main.cpp

#include <OneWire.h>
#include <DallasTemperature.h>
 
// Connect your yellow pin to Pin12 on Arduino
#define ONE_WIRE_BUS 4
 
// Setup a oneWire instance to communicate with any OneWire devices
OneWire oneWire(ONE_WIRE_BUS);
 
// Pass our oneWire reference to Dallas Temperature sensor 
DallasTemperature sensors(&oneWire);
 
void setup(void)
{
  // initialize the Serial Monitor at a baud rate of 9600.
  Serial.begin(9600);
  
  sensors.begin();
}
 
void loop(void){ 
  // Call sensors.requestTemperatures() to issue a global temperature and Requests to all devices on the bus
  sensors.requestTemperatures(); 
  
  Serial.print("Celsius temperature: ");
  Serial.print(sensors.getTempCByIndex(0)); 
  Serial.print(" - Fahrenheit temperature: ");
  Serial.println(sensors.getTempFByIndex(0));
  delay(1000);
}
