Ekter/fishe/Codes/Test/cours2/src/ph.cpp

/*
Once uploaded, open the serial monitor, set the baud rate to 9600 and append "Carriage return"
The code allows the user to observe real time pH readings as well as calibrate the sensor.
One, two or three-point calibration can be done.

Calibration commands:
 low-point: "cal,4"
 mid-point: "cal,7"
 high-point: "cal,10"
 clear calibration: "cal,clear"
*/

#include "ph_grav.h"                                  //header file for Atlas Scientific gravity pH sensor
#include <OneWire.h>
#include <DallasTemperature.h>

#define ONE_WIRE_BUS 2              // Data wire is plugged into digital pin 2 on the Arduino

OneWire oneWire(ONE_WIRE_BUS);        // Setup a oneWire instance to communicate with any OneWire device

DallasTemperature sensors(&oneWire);          // Pass oneWire reference to DallasTemperature library

String inputstring = "";                              //a string to hold incoming data from the PC
boolean input_string_complete = false;                //a flag to indicate have we received all the data from the PC
char inputstring_array[10];                           //a char array needed for string parsing
Gravity_pH pH = A0;                                   //assign analog pin A0 of Arduino to class Gravity_pH. connect output of pH sensor to pin A0
void parse_cmd(char* string) {                      //For calling calibration functions
  strupr(string);                                   //convert input string to uppercase

  if (strcmp(string, "CAL,4") == 0) {               //compare user input string with CAL,4 and if they match, proceed
    pH.cal_low();                                   //call function for low point calibration
    Serial.println("LOW CALIBRATED");
  }
  else if (strcmp(string, "CAL,7") == 0) {          //compare user input string with CAL,7 and if they match, proceed
    pH.cal_mid();                                   //call function for midpoint calibration
    Serial.println("MID CALIBRATED");
  }
  else if (strcmp(string, "CAL,10") == 0) {         //compare user input string with CAL,10 and if they match, proceed
    pH.cal_high();                                  //call function for highpoint calibration
    Serial.println("HIGH CALIBRATED");
  }
  else if (strcmp(string, "CAL,CLEAR") == 0) {      //compare user input string with CAL,CLEAR and if they match, proceed
    pH.cal_clear();                                 //call function for clearing calibration
    Serial.println("CALIBRATION CLEARED");
  }
}

void serialEvent() {                                  //if the hardware serial port_0 receives a char
  inputstring = Serial.readStringUntil(13);           //read the string until we see a <CR>
  input_string_complete = true;                       //set the flag used to tell if we have received a completed string from the PC
}

void setup() {
  Serial.begin(9600);                                 //enable serial port
  if (pH.begin()) { Serial.println("Loaded EEPROM");} 
  Serial.println(F("Use commands \"CAL,4\", \"CAL,7\", and \"CAL,10\" to calibrate the circuit to those respective values"));
  Serial.println(F("Use command \"CAL,CLEAR\" to clear the calibration"));
}

void loop() {
  if (input_string_complete == true) {                //check if data received
    inputstring.toCharArray(inputstring_array, 30);   //convert the string to a char array
    parse_cmd(inputstring_array);                     //send data to pars_cmd function
    input_string_complete = false;                    //reset the flag used to tell if we have received a completed string from the PC
    inputstring = "";                                 //clear the string
  }
  Serial.println(pH.read_ph());                       //output pH reading to serial monitor
  sensors.requestTemperatures();   // Send the command to get temperatures
  Serial.print("Temperature: ");      //print the temperature in Celsius
  Serial.print(sensors.getTempCByIndex(0));
  Serial.print((char)176);                    //shows degrees character
  Serial.println("C");
  delay(1000);
}
