Ekter/fishe/(commit log)

2022-10-08 docs (initial report) : updated needed materials and prices
2022-10-14 added temp sensor test
2022-10-14 added temp sensor digital
2022-10-14 added exemple code for the temperature and ph sensors
2022-11-14 add project files for Lebreton
    [socle arduino Nathan_Dumand.f3d]
2022-11-15 new one
    [socle arduino Nathan_Dumand.f3d]
2022-11-15 move to another files
    [socle arduino Nathan_Dumand.f3d]
2022-11-16 travail pour xavier(moche et ça salit le github)
    [boite raspy pico Nino Mulac.f3z]
2022-11-16 ajout morse en zip + code source
    c'est un projet platformio, vous pouvez le téleverser avec platformio directement
    sinon, il faudra télécharger le code complet(main, les deux Morse, et les Translator, et renommer le main en ino pour pouvoir compiler
2022-11-23 rename and move folders
    [boite raspy pico Nino Mulac.f3z, dump-database.service.txt, dump-database.timer.txt, setup-dump-database-logs.txt, setup-dump-database-service.txt, socle arduino Nathan_Dumand.f3d]
2022-11-25 first try
    [thrust_cover.3mf]
2022-11-29 morse code, optimised and commented, without delay Put main.ino , Morse and Translator, .cpp and .h into a folder "main" to be able to upload it to arduino. Or use platformio and just unzip the folde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
2022-12-10 added 3mf printed models
    [fishell.3mf, fishell3mf.3mf, nazefishe.3mf]
2022-12-17 docs : added flowing simulation type check
2023-01-11 started the connection and data transfer
    [data_to_send.csv]
2023-01-13 feat : added jetson nano server, need testing
    [data_to_send.csv]
2023-01-18 add led server
2023-02-06 modify send data
    [data_to_send.csv]
2023-02-17 feat :edit runserver
    [Untitled 2.ods, ressort.ods]
2023-02-17 docs : report 12+13, update to the spring model
    [ressort.ods]
2023-03-05 feat : edited python modules for raspberry pi
2023-03-06 feat : edit probe.py
2023-03-18 feat : test active pwm
2023-03-18 feat : active pwm servo motor
2023-03-18 feat : active pwm done, must be tested with oscillo
2023-03-21 feat : arduino connection
2023-03-21 arduino connection
2023-04-22 docs : add report 20
    [data_to_send.csv]
2023-04-29 feat : works for pico, even unplugged
2023-04-30 feat : probe sends real data
2023-04-30 feat : probe measure catches exceptions
2023-05-03 feat : added probe Z control
2023-05-08 feat : print logs
2023-05-08 feat : correct mistake in angle computation
    [rudder.py]
2023-05-08 feat : mistakes in angles w'
    [rudder.py]
2023-05-08 feat : stop probe
2023-05-16 docs+refactor : move things, correct typo
    [U v1.3mf, electrical_design_fishe_kicad.kicad_pcb, electrical_design_fishe_kicad.kicad_sch, electrical_design_probe_kicad.kicad_sch, fishell.3mf, fishell3mf.3mf, link rudder v1.3mf, nazefishe.3mf]
